JStafford00/OcularVirtualReality/Casing/Top.SLDPRT

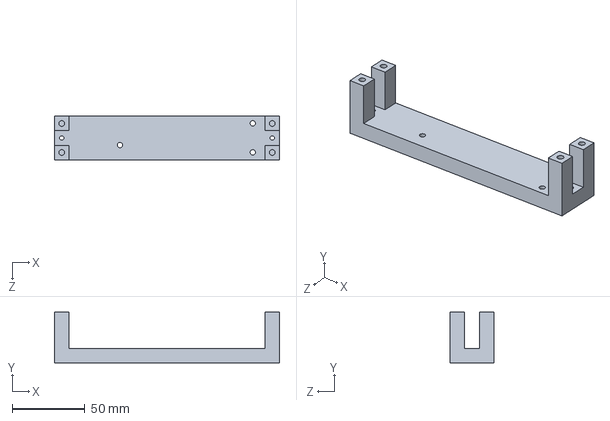
[picture p12: CAD file, 2021-08-22]
Casing/Top.SLDPRT
155.0 x 35.0 x 30.0 mm
