JStafford00/OcularVirtualReality/Casing/Bottom.SLDPRT

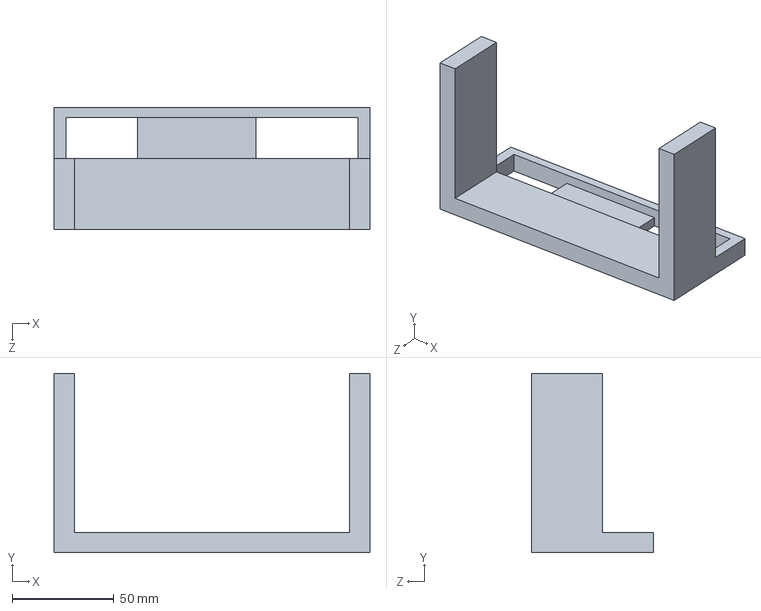
[picture p13: CAD file, 2021-08-22]
Casing/Bottom.SLDPRT
155.0 x 88.0 x 60.0 mm
