JStafford00/OcularVirtualReality/Casing/BottomAndFront.SLDPRT

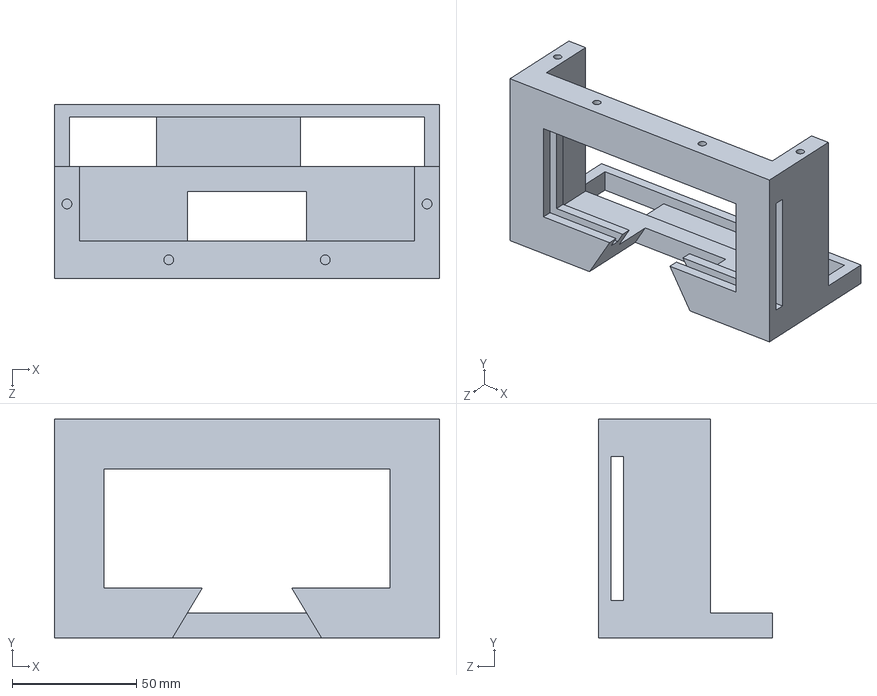
[picture p14: CAD file, 2021-08-22]
Casing/BottomAndFront.SLDPRT
155.0 x 88.0 x 70.0 mm
