JStafford00/OcularVirtualReality/Casing/LensPlateL.SLDPRT

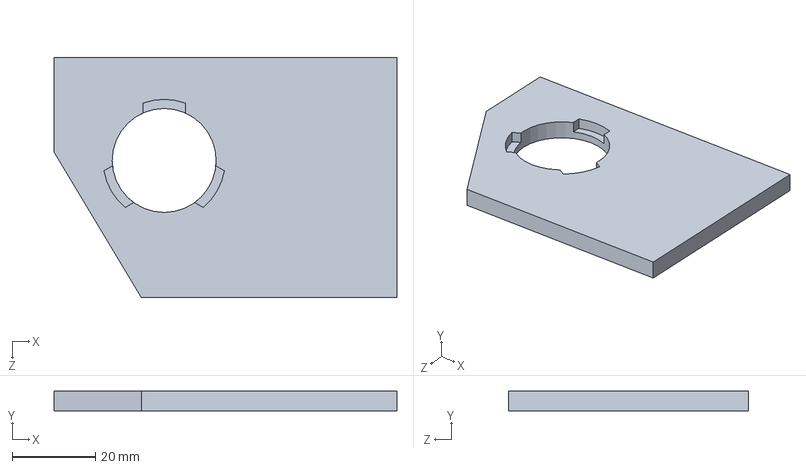
[picture p15: CAD file, 2021-08-22]
Casing/LensPlateL.SLDPRT
82.5 x 4.80 x 57.8 mm
