JStafford00/OcularVirtualReality/(list of files, cad)

Other CAD files:
Casing/LensPlateR.SLDPRT
Casing/Bottom.3MF
Casing/BottomAndFront.3MF
Casing/BottomAndFront.STL
Casing/LensPlateL.STL
Casing/LensPlateR.STL
Casing/Top.3MF
Casing/Top.STL
